cherryphilip74/iSpindel-PCB/(threads)

Thread 2 (2019-05-31):

Tilt not going lower than 0°P

BulletMag, 2019-05-31:
Use a v4 board but had to attach a 10g weight above the gyro board to get the unit to around 27° in plain water,
I configured using the instructions laid out in the original document and everything was working fine so popped it in a wine I was starting, for the first 48 hours the SG curve was moving as expected until it reached 1.000 (27.06° tilt)and then it remained that way for the last 36 hours.
i read somewhere else (it escapes me where) that you said weights were not needed but i did need to add some to get the unit to the required 26° (ish) tilt

as there are no instructions for the V4 boards and the gyro is moved to the bottom is the centre of gravity now not being registered correctly?
Previous designs have had the gyro at the pivot point (where the iSpindle breaks the surface of the liquid) but this is much lower.

I was wondering if anyone else has met with this issue?

cherryphilip74, 2019-06-01:
Hi @BulletMag, could you tell me what battery brand did you use?
The 4.0 pcb can it reach the correct tilt if you use a battery with equivalent weight between from 44 to 48gr. Could you share some pic of your iSpindel? I confirm that on this version ballast is not needed and I reached always a tilt around to 25 degree.

BulletMag, 2019-06-01:
I originally brought this as a kit from eBay but after seeing your PCB i decided to have some made up and use that instead, i needed to buy other components such as the 6 pin lipo charger board and the correct battery holder to comply with your BOM, the battery that was supplied to me was branded "UltraFire"

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

I didn't weigh it before i configured and calibrated the unit.
the iSpindle in question is currently in a brew with a couple of days to go so i can't provide photos at this time.

What weight are the batteries you use stand alone ? this way i can shop for a better candidate.

I thank you for your reply and will keep you updated

cherryphilip74, 2019-06-01:
Hi, now is clear for me! Did you use a wrong battery for this pcb, in fact they weight around 22/25gr. You have add a 10 gr ballast for reach the right tilt. Now, you can buy a Samsung 30Q 18650 battery, it weight is 46gr and you can also remove the ballast.

Closed 2019-06-01.

Thread 3 (2019-08-21):

V4 PCB Deep Sleep not waking up

GarySwanepoel, 2019-08-21:
Please can you assist me. I purchased PCB rev 4 Boards from PCBWay.
My Ispindel sends data to ubidots the first time and then wont wake up again to send data again.
I have read up comments regarding the Bat 43 diode vs 330 resistor and have tried both with no effect. I am a novice when it comes to building an IOT device and would appreciate it if you could spot any mistakes that I might have made. I have attached some photos and setup.
This is the second one that I have built with the same problem.
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
Thanking you in advance

trafim-uakraine, 2019-11-19:
I have already written many times, he will not wake up.  Doit.am should not be written on the module

cherryphilip74, 2019-11-29:
did you solve or not?

trafim-uakraine, 2019-11-29:
No

Thread 4 (2019-09-02):

Alternative to 18650 holder?

Naesstrom, 2019-09-02:
I was just wondering if [this](https://www.banggood.com/5pcs-DIY-1-Slot-18650-Battery-Holder-With-Pins-p-1094146.html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) would work as an alternative to the holder you are using if it's glued?
Not sure what pin spacing it is on yours?
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

cherryphilip74, 2019-11-29:
i will check this opportunity

Thread 5 (2019-09-12):

Rst holes on top corner

p0ttsworth, 2019-09-12:
What is the intended use of the rst holes?

I soldered a link across them as one video showed, but this prevented the board from connecting via wifi or USB. Removing the link fixed it.

Is it intended to be for a button?

Closed 2020-11-08.

Thread 6 (2019-10-23):

DS18B20 solders damages battery

Naesstrom, 2019-10-23:
I suddenly had some problems with the temp sensor stops working and I think I've found the reason.
On the V4 board the DS18b20 sensor is positioned at the bottom and if the soldering can damage the protective film on batteries. I'm guessing that short circuited my sensor, hoping it will be enoough to just replace it.
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

cswelin, 2019-10-23:
The instructions indicate you should try to keep these flat as possible.

Naesstrom, 2019-10-23:
> The instructions indicate you should try to keep these flat as possible.

I never found and written instructions for the v4 so I used Phillipo's video as a guide, my misstake then! Will try and replace the sensor and hope the rest works!

ErikdBr, 2021-01-18:
Stick the legs of the sensor through the holes and keep the sensor in place by bending the outer two legs. Then cut of the middle one as close to the hole as possible, then solder the middle one, repeat for the other legs. That way you get nice flat soldered dots.

jiblits, 2021-06-01:
Yeah I'm also having this issue. It was blowing the leads on the board and causing the probes to stop working.

I'm thinking wondering if it's possible to do a slight redesign where the battery is moved up slightly. When I get around to fixing my busted boards I'm probably just going to throw some hot glue to provide some extra protection from this kinda damage.

cherryphilip74, 2021-06-02:
The DS18B20 probe sensor was moved outside holderbattery perimeter , just to avoid possible short with wall of the battery.  This improvement is available on new pcb 4.1 (already released).BRcherryphilipInviato dal mio Galaxy
-------- Messaggio originale --------Da: jiblits ***@***.***> Data: 02/06/21  01:39  (GMT+01:00) A: cherryphilip74/iSpindel-PCB ***@***.***> Cc: Subscribed ***@***.***> Oggetto: Re: [cherryphilip74/iSpindel-PCB] DS18B20 solders damages battery (#6)
Yeah I'm also having this issue. It was blowing the leads on the board and causing the probes to stop working.
I'm thinking wondering if it's possible to do a slight redesign where the battery is moved up slightly. When I get around to fixing my busted boards I'm probably just going to throw some hot glue to provide some extra protection from this kinda damage.

—You are receiving this because you are subscribed to this thread.Reply to this email directly, view it on GitHub, or unsubscribe.

Thread 7 (2019-10-23):

PCB thickness?

ps915, 2019-10-23:
I am about to produce some PCBs. Which thickness is recommended?

Naesstrom, 2019-10-24:
I made mine the standard 1.6mm

cherryphilip74, 2019-11-29:
1.6mm

Thread 8 (2019-10-23):

Difference between "new_TiltClone_4.0_Rev_A.zip" and "iSpndel_4.0.rar"

ps915, 2019-10-23:
Whats the difference on those two PCBs?

Naesstrom, 2019-10-24:
I never thought about the fact that there was 2 versions. Ran a quick comparison and you definitely want to use the one named  **"new_TiltClone_4.0_Rev_A.zip"** since the other one is missing the copper from the negative battery connection to the charger! (marked in red)
@cherryphilip74 you might want to remove the one not working!
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

cherryphilip74, 2019-12-12:
I removed it... soon a new version

Thread 9 (2019-11-05):

Link to PCBWay is broken

HexTank, 2019-11-05:
As title, just takes you to some page with various PCBs.

cherryphilip74, 2019-11-29:
Did you try again? Link working

HexTank, 2019-12-02:
Yes, it's this one on the main landing page.

https://www.pcbway.com/project/shareproject/publish.aspx?orderid=438558

Still takes me to a generic PCB way page that just has lots of generic product.

Thread 10 (2019-11-25):

[suggestion] rx/tx on v4.5?

Naesstrom, 2019-11-25:
Just a suggestion or rather a wish for any future versions of the pcb.
Wouldn't be that complicated to add rx, tx, 3.3 and gnd connections. To maintain balance add 2 to each side of the resistors. That would make it possible to connect with a USB-TTL adapter after mounting to reflash, read serialconsole etc.

mockup here:
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

cherryphilip74, 2019-11-29:
yes, I can do it

Thread 11 (2019-11-29):

Bigger  PETling

draxien, 2019-11-29:
Hello,
I've bought bigger PETling whitch has inside diameter ~40mm (lenght is about 123mm) is it possible to make another version of PCB that would fit inside it? I'am arfaid that "new_TiltClone_4.0_Rev_A.zip" would be almost impossible to be balanced

Closed 2019-12-23.

Thread 12 (2019-12-07):

Cant find the Gerber Files anymore!

ps915, 2019-12-07:
Where is the gerber file? I just saw you deleted it!

cherryphilip74, 2019-12-07:
I will update with the new version

Il Sab 7 Dic 2019, 20:52 Phillipp Seidel <notifications@github.com> ha
scritto:

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

ps915, 2019-12-07:
I don't want to rush you but i am about to order PCBs from china and would like to add it to my order! =)

When will you have finished the new version?

cherryphilip74, 2019-12-12:
end for year.

ps915, 2019-12-12:
If you are located in europe (i am from germany), i can send you a PCB for testing purposes when i get them from China. I'll be ordering via DHL Express which takes just a few days to arrive! =)

So if i can support you in this way, i am happy to do so! =)

cswelin, 2019-12-12:
> end for year.

Just of curiosity, what sort of changes have been made?

cherryphilip74, 2019-12-13:
yes, I live in Italy.

Filippo

*Sent:* Thursday, December 12, 2019 at 1:20 PM
*From:* "Phillipp Seidel" <notifications@github.com>
*To:* cherryphilip74/iSpindel-PCB <iSpindel-PCB@noreply.github.com>
*Cc:* cherryphilip <cherryphilip@email.com>, Comment <
comment@noreply.github.com>
*Subject:* Re: [cherryphilip74/iSpindel-PCB] Cant find the Gerber Files
anymore! (#12)

If you are located in europe (i am from germany), i can send you a PCB for
testing purposes when i get them from China. I'll be ordering via DHL
Express which takes just a few days to arrive! =)

So if i can support you in this way, i am happy to do so! =)

—
You are receiving this because you commented.
Reply to this email directly, view it on GitHub
<https://github.com/cherryphilip74/iSpindel-PCB/issues/12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>,
or unsubscribe
<https://github.com/notifications/unsubscribe-auth/AEVV6QWWVXJIRBAQ4XHVADLQYIUCDANCNFSM4JXRLA4A>
.

ps915, 2019-12-13:
Awesome, so when you have the Gerber Files ready, send it to blog[at]seidel-philipp.de together with your address and i take care of the rest :)

Greetings,
Phil

cswelin, 2019-12-14:
A side note for anyone, this is git so you can go back and pull a previous commit.

cherryphilip74, 2019-12-14:
Hi ,
here the new iSpindel-PCB with GY-521 module mounted directly on pcb. You can order the new version on JLCPCB.com and require smt assembly . I will put the gerber files, BOM and PicknPlace instruction on my github.
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

ps915, 2019-12-15:
nice! Do you also have a shematic by any chance! Still can't find the gerber files/bom/pick&place

cswelin, 2019-12-15:
> nice! Do you also have a shematic by any chance! Still can't find the gerber files/bom/pick&place

Go back to https://github.com/cherryphilip74/iSpindel-PCB/tree/iSpindel---SMD, its on another branch.

Thread 13 (2020-01-02):

Logging, but unable to reset to re-calibrate

micko247, 2020-01-02:
Hi, I have recently built two units (v3.2) & both are logging. (I actually had a number of issues, have built 10, especially with the temp logging, but I’ll leave that for another post).
I believe I got something wrong with the calibration as the SG stays at 1.004 regardless of the tilt. I use brewfather to log via http. I had no problems accessing configuration until now after they’ve started logging. I cannot access the config even though the wemos does rest and try to open an access point but it logs out.

Thanks in advance, Mick

cswelin, 2020-01-02:
Append [SG] to the name, since it’s reporting in SG BF requires [SG] in the name.

micko247, 2020-01-02:
Thanks cswelin, do you mean the name of the spindle? Mine are Red and Blue. Do you have a link that describes this? Thanks

cswelin, 2020-01-02:
@micko247

Correct, in the ispindel configuration, so you’d namw yours Red[SG] and Blue[SG]. I’ve never had luck putting it as a prefix (would still report 1.004), only suffix.  Here’s the doc explanation it https://docs.brewfather.app/integrations/ispindel

micko247, 2020-01-02:
Great thanks. Unfortunately I can’t access configuration. I may try re-loading the firmware. Thanks

cswelin, 2020-01-02:
You should be able to reset to config mode by shorting the two holes on the top of the PCB a couple times In row. (on the part that sticks out)

micko247, 2020-01-02:
I don’t think the v3.2 has this. The reset on the wemos does work, the light starts blinking, and it establishes an access point I can connect to on my computer. But it doesn’t connect successfully. I’ve tried several times on both units.

cswelin, 2020-01-02:
Right,
Does it connect to the access point but not load the captive portal? if so, try going to `192.168.4.1` in the browser

micko247, 2020-01-02:
Correct, and I’ve tried 192.168.4.1

micko247, 2020-01-02:
Ahhh, now I see the bit about Plato & SG. I’d missed that bit. Cheers

micko247, 2020-01-06:
Specific issue fixed, for some reason Chrome went offline.

Closed 2020-01-06.

Thread 14 (2020-01-03):

Using 50ml centrifuge tubes?

fodi666, 2020-01-03:
Hi,
seeing the SMD version I had some hopes that the iSpindel could be redesigned to fit in a [50ml Falcon tube](https://images-na.ssl-images-amazon.com/images/I/31Zpw7D9RQL._SX342_.jpg). I made some measurements:
total external length: 114mm
total length before the conical end, which has full width: 99mm
internal diameter: 27mm

Is it possible to squeeze everything in? Could you prepare a smaller version? I am willing to use a shorter battery if needed (like 14500 which is the size of AA batteries)

Further images of my measurements: [https://imgur.com/a/oD1Yfmx](https://imgur.com/a/oD1Yfmx)

Thanks

cherryphilip74, 2020-01-03:
Yes, i can try..

I need few weeks, at the moment I'm working filling controller.

Il Ven 3 Gen 2020, 17:23 fodi666 <notifications@github.com> ha scritto:

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

fodi666, 2020-01-13:
hi,
finally I tried designing one that seems to be working: https://easyeda.com/editor#id=|7bb079167e2c425f9a1a1b8b64ef0805|5c77f5e7a6c54715b207900c2b6ad742|88466c52a5cc43fba402472e6034949a|83aeb81fb016464bba86769db916da22
I removed the charger board to save some space and recreated the GY521 from its components to avoid daughter boards
I also used a bare ESP-12S board instead of the Wemos

cherryphilip74, 2020-01-21:
Link not work

gnalbandian, 2020-02-12:
Did this worked for you? Can you expand on your experience? Thanks!

Thread 15 (2020-01-03):

jlcpcb.com doesn't match some parts

rackam74, 2020-01-03:
Hi, I think the BOM/CPL aren't uptodate with jlcpcb.com, isn't it??

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

rackam74, 2020-01-04:
I've tried again, and it's ok!

cherryphilip74, 2020-01-04:
Ok, thanks

Il Sab 4 Gen 2020, 19:25 rackam74 <notifications@github.com> ha scritto:

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

Closed 2020-01-04.

Thread 16 (2020-01-06):

Any reported problems with the build of v3.2 PCB?

micko247, 2020-01-06:
Hi, I have tried to build 10 units and had various issues, particularly the ability to log temperature and perseverence of logging. I am not an electrician but have run my builds through a colleague that is an electrical engineer who successfully built units with other PCBs (unsure if cherryphilip builds).
Thanks, Mick

ErikdBr, 2021-01-18:
I have bought a couple of these and I would like to know if I should use a protected 18650 battery if I don't remove the diode on the Wemos?

Thread 17 (2020-01-15):

Reply to your last email

jhwerner1, 2020-01-15:
**[Your Quote]()** "After flashing pls you solder the Wemos on pcb... i don't know what is the
issue."

**The issue is...**
After re-installing the Wemos, I still cannot get it to set an access point, cannot re-flash with NODEMCU, logs said "Finding device", never finds.

Followed your Technical Details/ Components instructions to the letter.

Question: Concerning https://jlcpcb.com, when I ordered, they show  images of SMD board with
Original part placement and  Corrected Part Placement.

They rotated the D1 Diode 180 degrees, they also rotated the IC2 & IC2 components 90 degrees on the corrected part placement image. Is this causing my issues? If it is how due I prevent them from making changes?

Joe

cherryphilip74, 2020-01-15:
could you send me the DFM analysis that can you find inside to order
history? I want to check if jlcpcb provided to correction or not. The
preview is not real.

Thanks
Filippo

Il Mer 15 Gen 2020, 17:39 jhwerner1 <notifications@github.com> ha scritto:

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

cherryphilip74, 2020-01-15:
Hi @jhwerner1 ,
here a screenshot of layout
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
All devices are in correct position, but i want to understand the real issue.
Could you send me some pics of the pcb? Where are you live? We can organize a pickup for shipment at my attention
Thanks and Regards
Filippo

jhwerner1, 2020-01-15:
I copied and pasted the images from the DFM Analysis into a Word Document
attached to this email.

[image: image.png]
[image: image.png]

Original parts             Actual Placement
placement

On Wed, Jan 15, 2020 at 2:10 PM cherryphilip <notifications@github.com>
wrote:

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

cherryphilip74, 2020-01-15:
The actual placement is correct.

jhwerner1, 2020-01-15:
Is this suggestion from an earlier post correct?

Quote "You might want to try to manually force GPIO0 (pin D3 on the board)
low (this initiates firmware upload mode) after reset of the Wemos.

   - Remove USB
   - Connect D3 to GND
   - Plug-in USB
   - Try upload in firmware.
   - disconnect D3 from GND"

On Wed, Jan 15, 2020 at 5:07 PM cherryphilip <notifications@github.com>
wrote:

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

Closed 2020-01-15.

Thread 18 (2020-01-15):

I can't flash!

rackam74, 2020-01-15:
Hi I've just received the new SMD version.
WHen i finished to build it. I try to flash it.... but it's impossible. Nocemcu programmer is stucked
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
I've tried to flash the wemos before soldering.... I can't attach a video.... but with putty there are  some characters that scroll very quickly.
I've already build some of your old pcb, and I didn't have this problem.

cherryphilip74, 2020-01-15:
Hi rackam74,
could you ship me the pcb?
Of course shipping at my expense.
Pls send me an email : cherryphilip@email.com

thanks

rjaakke, 2020-01-15:
You might want to try to manually force GPIO0 (pin D3 on the board) low (this initiates firmware upload mode) after reset of the wemos.

- Remove USB
- Connect D3 to GND
- Plug in USB
- Try upload in firmware.
- disconnect D3 from GND

I have 5 of them coming in tomorrow so hope this can be fixed somehow. Still waiting on other parts coming in from China so I can't test it yet.

@cherryphilip74 correct me if I'm wrong on this suggestion.

rackam74, 2020-01-16:
@rjaakke i've send the pcb to @cherryphilip74, so I will check it! I hope it will find the issue!

cswelin, 2020-01-17:
Interested in this well, had a few boards built, once assembled its no longer flashable also scrolls random chars and blue LED stays on.

jhwerner1, 2020-01-17:
Sounds like the same problem I've been having.

On Thu, Jan 16, 2020 at 9:41 PM Colin Swelin <notifications@github.com>
wrote:

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

cherryphilip74, 2020-01-18:
workaround
https://github.com/cherryphilip74/iSpindel-PCB/issues/19#issue-551776899

Thread 19 (2020-01-18):

PCB design issues & work-arounds

jwlusby, 2020-01-18:
I recently built a batch of these and found a couple of issues and found work-arounds

**#1 The 3.3v LDO (IC1) has it's  !EN pin tied to "IN".**
This caused the LDO to not turn on. Instead, this should be tied to GND or possibly some other pin on the WEMOS so that it could control turning on/off the MPU6050 IC.

The trace with the red X's in this image show what should be remove and the green rectangle shows where a trace should be added.

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
**SYMPTOMS**
- Inability to program WEMOS while connected to the iSpindel PCB.
- Garbage serial output. Appears as if the BAUD rate is wrong.
- Stuck blue light on reset
- Failure to enter Config mode

**WORKAROUND** I was able to work around the issue be de-soldering the IC, bending the !EN pin up and soldering a small jumper wire between it and the GND pin next to it.

**#2 Pin 8 (VLOGIC) of IC2 (The MPU-6050) does not have a connection to the 3.3V input of VDD (Pin #13)**

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

**SYMPTOMS**
- No data from MPU-6050 accelerometer (Data is always 0)

**WORKAROUND:** Solder a jumper from the VLOGIC side of C6 to the 3.3V side of R1.
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

cherryphilip74, 2020-01-18:
Hi @jwlusby,
Thanks, thanks a lot!!!
I'm waiting some boards juststart a failure analysis and possible workaround when I did receive email notification with your post.
LDO = type error.. I latched the ouput with EN in pull-up instead of in pull-down (my error)
VLOGIC: I got the model from another sketch where the PIN is connected to GND with capacitor without 3V3. In fact you're right and as reported on DSH this pin must be connect at 3V3.
(see proto supplies scheme vs other schematic)
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

There are a lot of GY521 modules doesn't work (0.00°), I wonder if the root cause is the same, VLOGIC fault due to V3V missed.

Another question: could you tell me the tilt value got in flat water?

I will update the schematic, when I will be complete the analysis.

Cheers!
Filippo (cherryphilip)

jhwerner1, 2020-01-18:
Will you let us know when you have uploaded the correct files to JLCPCB.COM, I would rather order the correct version of the PCB, then attempting to make the workaround corrections suggested above.
Joe

cherryphilip74, 2020-01-18:
Yes

Il Sab 18 Gen 2020, 20:16 jhwerner1 <notifications@github.com> ha scritto:

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

jwlusby, 2020-01-19:
Thanks for the quick reply. I'm glad that I could help in some way!

It seems like the issues other have reported could very well be a result of the VLOGIC pin not being connected to the 3.3V input.

> Another question: could you tell me the tilt value got in flat water?

With a freshly-built, non-calibrated iSpindel, and using the latest code from [https://github.com/universam1/iSpindel](url), I'm getting a Tilt value of 45.7°

cherryphilip74, 2020-01-20:
Use a battery with weight >= 48gr.
After calibration the tilt is between 22/26

Filippo

Il Dom 19 Gen 2020, 23:32 Jeremiah Lusby <notifications@github.com> ha
scritto:

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

jussipu, 2020-01-24:
Is this issue only on smd board?

cherryphilip74, 2020-01-24:
Yes. Bugs fixed, will be release gerber file soon.

Il Ven 24 Gen 2020, 18:40 jussipu <notifications@github.com> ha scritto:

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

rjaakke, 2020-01-24:
To make it a bit more easy to fix the smd board you can also remove the  !EN pin completely.
I thought I wrecked one board but documentation states !EN can be open or tied to GRD.

To fix issue 2 I soldered a jumper from the VLOGIC side of C6 to the 3.3V side of C2.
The C2 is much bigger in size so it was allot easier to solder.

If possible it would be nice if the C2 would be moved to the left or right in future versions. This would make it easier to plug in the micro USB to flash the wemos. With the current layout you have to lift the wemos a bit to allow plugging in the USB connector.

rtemplen, 2020-01-25:
Is this issue applicable to the 4.0 PCB?
https://www.pcbway.com/project/shareproject/iSpndel_4_0.html

cswelin, 2020-01-25:
> Is this issue applicable to the 4.0 PCB?
> https://www.pcbway.com/project/shareproject/iSpndel_4_0.html

No, that isn't a SMD board.

cmckay22, 2020-03-15:
Just as an update it seems there maybe still a small issue with the new SMD boards (Fixed version). I had some arrive this week and still had issues. I worked with cherryphilip74 yesterday and he found a simple workaround. I added a small solder jumper between the bottom two pins on the left side of the ic chip (pin 2 GND and pin 2 E) and lifted the GND on the right (bottom pin). I accidentally broke the pin on the right side and it still works so If you have soldering skills like me don’t worry about it.

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

rjaakke, 2020-04-29:
@cherryphilip74 was this a production fault or does the gerber need an update?

Thread 20 (2020-01-24):

tp4056 module only 4 connections

arjepsen, 2020-01-24:
Hey.
In the assembly guide page 7 is shown a tp4056 module similar to the one I have here.
It only has 4 solder holes (in+/- and bat+/-).
However, the pcb also has out+/-.
I can't see clearly in the guide how to exactly solder this up.
Please help
Regards Anders

Naesstrom, 2020-02-03:
I actually think you need the one with 6 holes.

cherryphilip74, 2020-02-03:
There is a version with 6 connections (tp4056 with protection)Il 3 Feb 2020 20:26, Erik Näsström <notifications@github.com> ha scritto:I actually think you need the one with 6 holes.

—You are receiving this because you are subscribed to this thread.Reply to this email directly, view it on GitHub, or unsubscribe.

Thread 21 (2020-02-03):

Tips for de-solder MPU-6050

Naesstrom, 2020-02-03:
So I have a bunch of v4's with none working Gyros that I need to desolder, any hints on how to remove them without damaging the gyro or the pcb! I was dumb enough to cut the pins on them before noticing that they didn't work so can't pull on them with pliers while heating!

rjaakke, 2020-02-04:
Use a desoldering pump, they are cheap  on eBay and AliExpress

Naesstrom, 2020-02-11:
Bought a dremel versatip, used the brad flame adapter and they came right off!

Closed 2020-02-11.

Thread 22 (2020-05-21):

deserializeJson() failed: NoMemory

Naesstrom, 2020-05-21:
When I try to save the new formula (-0.001344537*tilt^2 + 0.616671894*tilt - 13.73642293) it reboots and then the original formula is still there. Everything else seems to be working and the log says the config is saved?
```
saving config...
{"Name":"iSpindel000","Token":"","Sleep":900,"Server":"","API":0,"Port":80,"Channel":0,"URI":"","DB":"ispindel","Username":"","Password":"","Job":"ispindel","Instance":"000","Vfact":191.8,"TS":0,"OWpin":12,"POLY":"-0.002083958*tilt^2 + 0.737917168*tilt - 18.06203205","SSID":"","PSK":"","Offset":[0,0,0,0,0,0]}
saved successfully
```
The problem is that it then reboots 2 times and seems to save the standard config again?
```
saving config...
{"Name":"iSpindel000","Token":"","Sleep":900,"Server":"","API":0,"Port":80,"Channel":0,"URI":"","DB":"ispindel","Username":"","Password":"","Job":"ispindel","Instance":"000","Vfact":191.8,"TS":0,"OWpin":12,"POLY":"","SSID":"","PSK":"","Offset":[0,0,0,0,0,0]}
saved successfully
Samples:30 min:78.07 max:78.17 time:520
x: -3166 y: 14064 z: -590
Tilt: 78.12
Tacc: 24.22
Volt: 4.43
Temp: 22.87
Parse error at 1
Gravity: 0.00
After waiting 0ms, result 0
Rescue Wifi credentials
failed to connect
```
Only thing I can find in the log that could indicate some kind of problem is the `deserializeJson() failed: NoMemory` in the boot. Tried reinstalling and clearing memory etc.
```
FW 6.2.0
2.2.1(cfd48f3)
Worker run!
mounting FS... mounted!
reading config file
deserializeJson() failed: NoMemory
scanning for OW device on pin: 5
No devices found!
scanning for OW device on pin: 12
Found device with ROM = 28 C8 D6 16 A8 1 3C D9
  Chip = DS18B20
  Data = 1 70 1 55 5 7F A5 A5 66 C7  CRC=C7
  Temperature = 23.00 Celsius,
offsets not available
Boot-Mode: Deep-Sleep Wake

Double Reset detected
...........
ERROR no Wifi credentials

going to Config Mode
```

gingerneil, 2020-06-11:
I am seeing this on 6.2.0 also. I think this has been tracked down to an issue with the gyros, and is fixed by increasing the page size to 3. I am therefore using 5.8.6 for now until a fix is put into 6.2.1

Naesstrom, 2020-06-20:
@gingerneil any link to where it is discussed?

gingerneil, 2020-06-20:
It's covered by one of the issues on the ispindel git. It's fixed in 6.3.1.

Thread 23 (2020-07-22):

No link or file

DrBabbage, 2020-07-22:
Hey there, I dropped you a donation. Would it be possible for you send me the gerber files?
I would also love to have a BOM.
Nice project!

cherryphilip74, 2020-07-22:
Thanks a lot for donation.Im out of house, when I'll come back I will send you gerber files or you can also order pcb on pcbway.com (shared projects)Il 22 Lug 2020 19:28, DrBabbage <notifications@github.com> ha scritto:
Hey there, I dropped you a donation. Would it be possible for you send me the gerber files?
I would also love to have a BOM.
Nice project!

—You are receiving this because you are subscribed to this thread.Reply to this email directly, view it on GitHub, or unsubscribe.

DrBabbage, 2020-07-22:
Thank you SO much!
Will order them from jlcpcb so a gerber file would be awesome.
Do you know roughly when you are home again?
Don't stress yourself, I am working at a hospital and thanks to corona I have no time to do anything but working for at least 2 months.

DrBabbage, 2020-08-11:
hey, short question are you at home again?
Thank you so much!

cherryphilip74, 2020-08-11:
No! I'll come back after the Aug 17th.FilippoIl 11 Ago 2020 18:29, DrBabbage <notifications@github.com> ha scritto:
hey, short question are you at home again?
Thank you so much!

—You are receiving this because you commented.Reply to this email directly, view it on GitHub, or unsubscribe.

DrBabbage, 2020-12-03:
Could you send me the file ? :)
Thanks!

Thread 24 (2020-08-08):

In correct temperature reading

RYSAC, 2020-08-08:
I have just come round to calibrating my iSpindel Cherryphillips 4.0 and my temperature is reading as minus, -25.42.
When i initially turned on my iSpindel  temperature was reading correctly.
I have just tried re flashing the software and the issue is still present.
Any ideas how to rectify the issue?
Thanks

Thread 25 (2020-11-09):

Batteries positive contact issues

ThomasMcGloine, 2020-11-09:
I sourced 3 pairs of batteries from three different vendors trying to get "genuine" Samsung brand items but only one pair has a protruding positive tip that will connect to the protruding + contact on the battery holder.  All five of my holders seem to have the contact below the level of the plastic holder recessed so that only an extended positive tip on the battery will make contact.   With the two that do have the contact they seem to have an extra plastic wrap or coating that is sealing the battery, not just the green outer later.  I started to remove it but noticed the negative plate on the bottom of the batter was being held on by the coating.  With this version of the battery it does make contact  but the thickness of the battery is greater by this coating and extremely hared to seat and remove without pressure and prying that I fear will risk damaging other part in the process.  So using the two other versions, I need to use something like extending tip with solder on the top of the battery to make contact.  This I suspect is adding weight to throw off the calibration. Tried to add a small tip of solder to the one battery but not able to heat the metal enough to get a good bond fearing damage to the internal battery.  Added a pair of small washer and filled the center with solder and makes contact to change but not sure if it will stay bonded over time and the weight added.  Any thoughts or a true source for batteries that make contact correctly and do not exceed the width of the holder or is it my holders that are recessed incorrectly?

Thread 27 (2020-11-30):

PCB 31mm Wide?

enorfelt, 2020-11-30:
Just received my boards from pcbway. When I ordered them I saw that they where 31mm wide. Is that correct? They feel kind of loose in an XL petling with 33mm inner dimension.

Thx!

ljruiten, 2021-04-14:
I have this exact same problem, did you manage to find a good workaround? The PCB not moving inside the tube is kind of key to the working of this device..

cherryphilip74, 2021-04-14:
I'm sorry,  you can use a scotch tape on top of battery.Il 14 Apr 2021 20:05, ljruiten ***@***.***> ha scritto:
I have this exact same problem, did you manage to find a good workaround? The PCB not moving inside the tube is kind of key to the working of this device..

—You are receiving this because you are subscribed to this thread.Reply to this email directly, view it on GitHub, or unsubscribe.

ljruiten, 2021-04-17:
@enorfelt actually after further investigation this is not an issue... You have to realize that in the perfect situation the ispindel should have three contact points with the casing: either side of the PCB, and the battery...
Therefore the PCB is not centered in the casing, it is lowered, get it? I just added the battery holder and the battery and could not even fit the PCB in the case, had to sand down the sides of the PCB which now has a perfect fit with the case.

enorfelt, 2021-04-17:
> @enorfelt actually after further investigation this is not an issue... You have to realize that in the perfect situation the ispindel should have three contact points with the casing: either side of the PCB, and the battery...
> Therefore the PCB is not centered in the casing, it is lowered, get it? I just added the battery holder and the battery and could not even fit the PCB in the case, had to sand down the sides of the PCB which now has a perfect fit with the case.

That makes perfect sense! Thank you 😊

Closed 2021-04-17.

Thread 28 (2021-01-18):

Where is antenna on SMD pcb?

Grafek3d123, 2021-01-18:
Hello, i tink that esp MCU must be connect to pcb antenna. But i did not find it in smd pcb. How it is working without?

DrBabbage, 2021-03-27:
I don't know exactly what you mean by that but there is an antenna on the wemos
