cherryphilip74/iSpindel-PCB/(commit log)

2019-02-23 Create README.md
    ### DESCRIPTION
    PCB for PETlng 122mm / d33mm for iSpindel project (electronic Hydrometer)
    https://github.com/universam1/iSpindel/blob/master/docs/README_en.md
    ### TECHNICAL DETAILS / COMPONENTS
    - 1 Plastic cylinder
    ( http://www.geoshop.lt/index.php?route=product/product&path=20_26&product_id=285#.WoBTg-jOXIU )
    - 1 resistor 4k7ohm
    - 1 resistor 220kohm
    - 1 diode BAT43
    - 1 Wemos D1 mini v2 (or compatible)
    - 1 Gy-521 Gyro & Acceleration Sensor (MPU-6050
    - 1 Temperature Sensor (DS18B20)
    - 1 TP4056 Lipo Charger micro USB 4 pin (mini USB is bigger)
    - 1 microswitch SK12D07VG3
    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
2019-02-23 Add files via upload
    link for pcbway.com:
    <a href="https://www.pcbway.com/project/shareproject/ISpindel_PCB_3_2__bugs_fixed_.html"><img src="https://www.pcbway.com/project/img/images/frompcbway.png" alt="PCB from PCBWay" /></a>
2019-12-15 new iSpindel SMD version
    Spindel-SMD
    This is a modified version of iSpindel drawer proposed in PCB format instead of 3d print. The project is available at: https://github.com/universam1/iSpindel Two folder for different pcb solution (short and long pcb)
    DESCRIPTION
    TECHNICAL DETAILS / COMPONENTS
    1 Plastic cylinder (http://www.geoshop.lt/index.php?route=product/product&path=20_26&product_id=285#.WoBTg-jOXIU)
    1 Wemos D1 mini v3
    1 TP4056 Lipo Charger micro USB 4 pin (mini USB is bigger)
    1 microswitch SK12D07VG3 ( https://www.pcbway.com/project/shareproject/publish.aspx?orderid=438558 )
    LEARN / TOPIC / BUILD I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
2020-09-15 iSpindel SMD
    It's the same version of iSpindel 4.0 but with the GY 521 module mounted directly on the pcb.
    Choose WWW.JLPCB.COM for pcb fabrication
2020-09-15 iSpindel PCB 4.0
    iSpindel PCB 4.0
2021-02-07 iSpindel Gyro
    There are some GY-521 module that don't work well and give 0.00° or NAN because they aren't recognized due to "WHO I AM" failed (probably they are fake). This version includes the gyroscopic directly on the pcb and avoids obtaining an incorrect data.
